amosborne/tp325-meter/kicad/tp325-meter.pdf

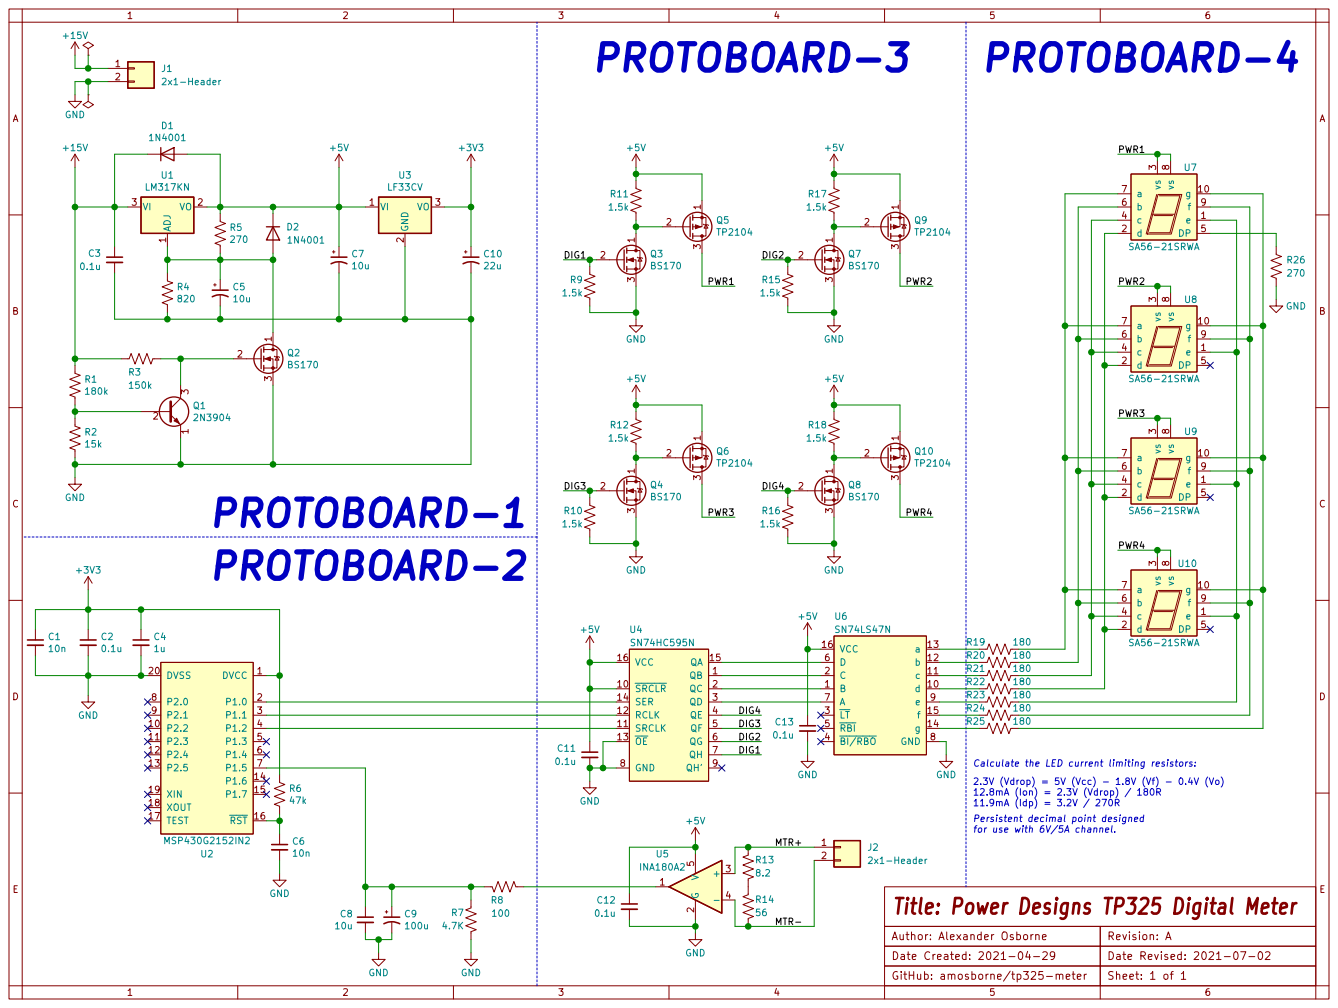
[picture p3: page 1]

for use with 6V/5A channel. Calculate the LED current limiting resistors:
2.3V (Vdrop) = 5V (Vcc) - 1.8V (Vf) - 0.4V (Vo)
12.8mA (Ion) = 2.3V (Vdrop) / 180R
11.9mA (Idp) = 3.2V / 270R
Persistent decimal point designed

Revision: A Date Revised: 2021-07-02 Author: Alexander Osborne Date Created: 2021-04-29
