amosborne/tp325-meter/kicad/tp325-meter.sch

## KiCad design kicad/tp325-meter.sch (2021-07-02)

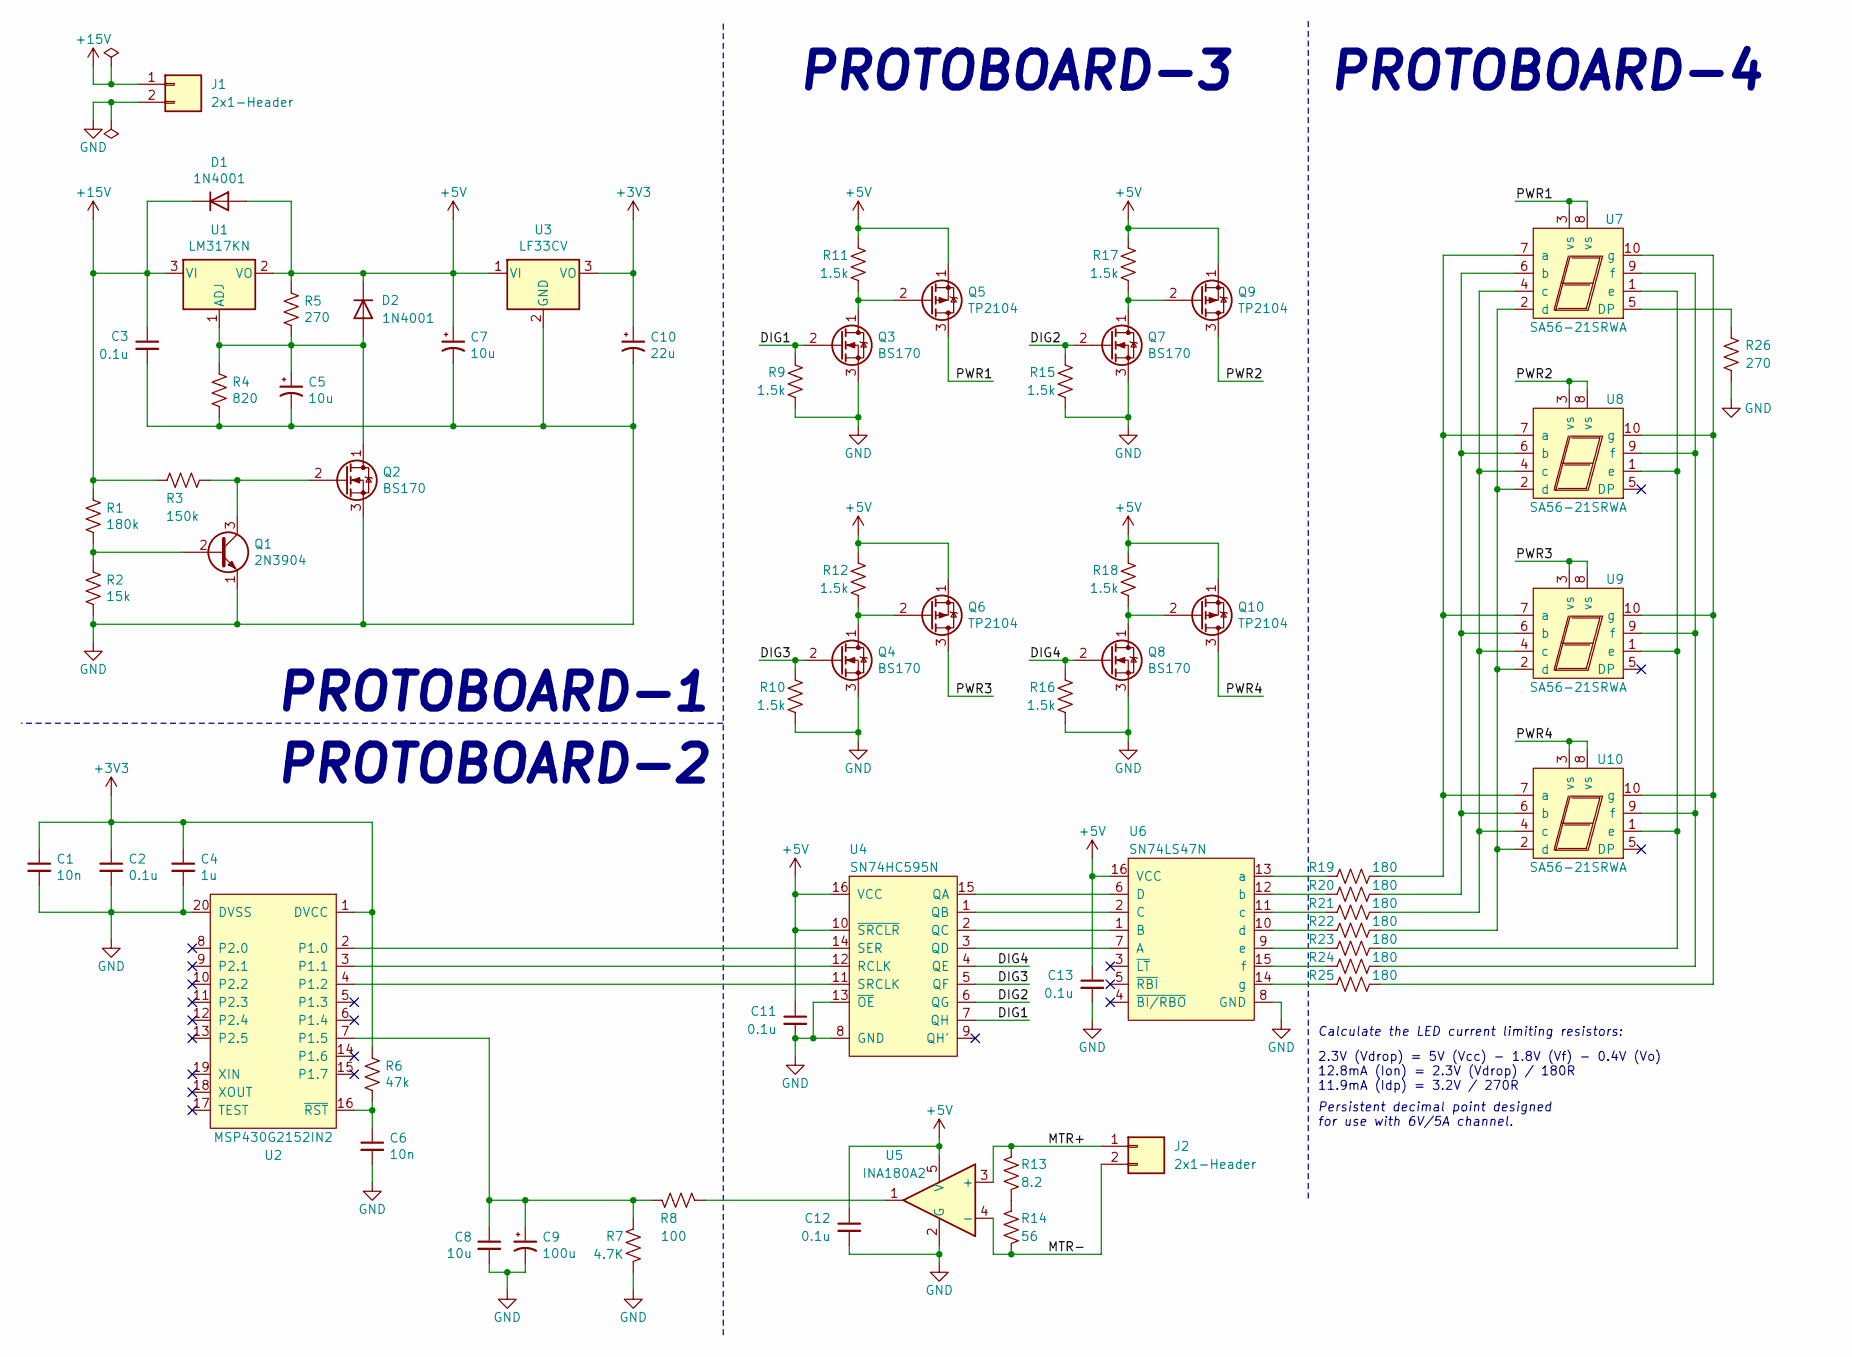
[picture p4: schematic tp325-meter.sch]

Parts:
C1, C6: 10n
C2, C3, C11, C12, C13: 0.1u
C4: 1u
C5, C7, C8: 10u
C9: 100u
C10: 22u
D1, D2: 1N4001
J1, J2: 2x1-Header
Q1: 2N3904
Q2, Q3, Q4, Q7, Q8: BS170
Q5, Q6, Q9, Q10: TP2104
R1: 180k
R2: 15k
R3: 150k
R4: 820
R5, R26: 270
R6: 47k
R7: 4.7K
R8: 100
R9, R10, R11, R12, R15, R16, R17, R18: 1.5k
R13: 8.2
R14: 56
R19, R20, R21, R22, R23, R24, R25: 180
U1: LM317KN
U2: MSP430G2152IN2
U3: LF33CV
U4: SN74HC595N
U5: INA180A2
U6: SN74LS47N
U7, U8, U9, U10: SA56-21SRWA

Connections:
+3V3: C1.1, C2.1, C4.1, C10.1, R6.1, U2.1 (DVCC), U3.3 (VO)
+5V: C7.1, C11.1, C12.1, C13.1, D1.2 (A), D2.1 (K), Q5.1 (S), Q6.1 (S), Q9.1 (S), Q10.1 (S), R5.1, R11.1, R12.1, R17.1, R18.1, U1.2 (VO), U3.1 (VI), U4.10 (~SRCLR), U4.16 (VCC), U5.5 (V), U6.16 (VCC)
+15V: C3.1, D1.1 (K), J1.1, R1.1, R3.2, U1.3 (VI)
DIG1: Q3.2 (G), R9.1, U4.7 (QH)
DIG2: Q7.2 (G), R15.1, U4.6 (QG)
DIG3: Q4.2 (G), R10.1, U4.5 (QF)
DIG4: Q8.2 (G), R16.1, U4.4 (QE)
GND: C1.2, C2.2, C3.2, C4.2, C5.2, C6.2, C7.2, C8.2, C9.2, C10.2, C11.2, C12.2, C13.2, J1.2, Q1.1 (E), Q2.3 (S), Q3.3 (S), Q4.3 (S), Q7.3 (S), Q8.3 (S), R2.2, R4.2, R7.1, R9.2, R10.2, R15.2, R16.2, R26.2, U2.20 (DVSS), U3.2 (GND), U4.8 (GND), U4.13 (~OE), U5.2 (G), U6.8 (GND)
MTR+: J2.1, R13.2, U5.3 (+)
MTR-: J2.2, R14.1, U5.4 (-)
unnamed: C5.1, D2.2 (A), Q2.1 (D), R4.1, R5.2, U1.1 (ADJ)
unnamed: C6.1, R6.2, U2.16 (~RST)
unnamed: C8.1, C9.1, R7.2, R8.1, U2.7 (P1.5)
unnamed: Q1.2 (B), R1.2, R2.1
unnamed: Q1.3 (C), Q2.2 (G), R3.1
unnamed: Q3.1 (D), Q5.2 (G), R11.2
unnamed: Q4.1 (D), Q6.2 (G), R12.2
unnamed: Q7.1 (D), Q9.2 (G), R17.2
unnamed: Q8.1 (D), Q10.2 (G), R18.2
unnamed: R8.2, U5.1
unnamed: R13.1, R14.2
unnamed: R19.1, U6.13 (a)
unnamed: R19.2, U7.7 (a), U8.7 (a), U9.7 (a), U10.7 (a)
unnamed: R20.1, U6.12 (b)
unnamed: R20.2, U7.6 (b), U8.6 (b), U9.6 (b), U10.6 (b)
unnamed: R21.1, U6.11 (c)
unnamed: R21.2, U7.4 (c), U8.4 (c), U9.4 (c), U10.4 (c)
unnamed: R22.1, U6.10 (d)
unnamed: R22.2, U7.2 (d), U8.2 (d), U9.2 (d), U10.2 (d)
unnamed: R23.1, U6.9 (e)
unnamed: R23.2, U7.1 (e), U8.1 (e), U9.1 (e), U10.1 (e)
unnamed: R24.1, U6.15 (f)
unnamed: R24.2, U7.9 (f), U8.9 (f), U9.9 (f), U10.9 (f)
unnamed: R25.1, U6.14 (g)
unnamed: R25.2, U7.10 (g), U8.10 (g), U9.10 (g), U10.10 (g)
unnamed: R26.1, U7.5 (DP)
unnamed: U2.2 (P1.0), U4.14 (SER)
unnamed: U2.3 (P1.1), U4.12 (RCLK)
unnamed: U2.4 (P1.2), U4.11 (SRCLK)
unnamed: U4.1 (QB), U6.2 (C)
unnamed: U4.2 (QC), U6.1 (B)
unnamed: U4.3 (QD), U6.7 (A)
unnamed: U4.15 (QA), U6.6 (D)
PWR1: Q5.3 (D), U7.3 (vs), U7.8 (vs)
PWR2: Q9.3 (D), U8.3 (vs), U8.8 (vs)
PWR3: Q6.3 (D), U9.3 (vs), U9.8 (vs)
PWR4: Q10.3 (D), U10.3 (vs), U10.8 (vs)

Notes on the sheet:
2.3V (Vdrop) = 5V (Vcc) - 1.8V (Vf) - 0.4V (Vo) 12.8mA (Ion) = 2.3V (Vdrop) / 180R 11.9mA (Idp) = 3.2V / 270R
Calculate the LED current limiting resistors:
Persistent decimal point designed for use with 6V/5A channel.
PROTOBOARD-4
PROTOBOARD-3
PROTOBOARD-2
PROTOBOARD-1
