amosborne/tp325-meter/embed/lookup.h

const unsigned int ADC_LOOKUP[] = {0, 165, 375, 578, 796, 1002, 1203, 1407, 1606, 1815, 2030, 2235, 2450, 2661, 2871, 3074, 3279, 3490, 3703, 3904, 4100, 4320, 4520, 4740, 4930, 5040, 5090, 5240, 5450, 5660, 5870, 6080, };
