amosborne/tp325-meter/(commit log)

2021-04-30 worksheet template
    [tp325-ledmeter.kicad_pcb, tp325-ledmeter.sch]
2021-04-30 rename kicad files
    [tp325-meter.kicad_pcb, tp325-meter.sch]
2021-04-30 7seg display symbol
    [tp325-meter.sch]
2021-05-08 add shift registers
    [tp325-meter.sch]
2021-05-08 add microcontroller
    [tp325-meter.sch]
2021-05-08 add opamps
    [tp325-meter.sch]
2021-05-09 add LDOs, pass DRC
    [tp325-meter.sch]
2021-05-09 veroroute first cut
2021-07-02 mid-calibration process
2021-07-02 calibration complete. 98% flash utilization
2021-07-02 partial lib/sch fix
    [tp325-meter.kicad_pcb, tp325-meter.sch]
2021-07-02 protoboard-3 schematic
    [tp325-meter.sch]
2021-07-02 updated schematic
    [tp325-meter.sch]
